coenhird/UV-Temperature-field-data-logger/materials for 5 data loggers 190321.docx

List to make 5 more loggers:

= $698.23 before shipping

MCU: 13.20 x 5 = 66

Low power breakout: 11.17 x 5 = 55.85

Temp sensor: 9.645 x 20 =192.9

MOSFET switch: 5.16 x 5 = 25.8

Logger shield: 13.15 x 5 = 65.75

Battery holder: 14.44 x 2 (10 holders) = 28.88

Toggle switch: 3.24 x 5 = 16.2

AA batteries: 14.99 x 8 = 119.92

SD card: 7.30 x 5 = 36.5

Headers: 1.95 x 15 = 29.25

Solder: 26.44

Hookup wire: 34.74

MCU x 5

https://core-electronics.com.au/uno-r3.html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

Low power breakout x 5

https://core-electronics.com.au/adafruit-tpl5110-low-power-timer-breakout.html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

Hookup wire x 1

https://core-electronics.com.au/hook-up-wire-assortment-solid-core-22-awg.html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

Temp sensor x 20

https://core-electronics.com.au/mcp9808-high-accuracy-i2c-temperature-sensor-breakout-board.html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

mini MOSFET switch x 5

https://core-electronics.com.au/mini-mosfet-slide-switch-with-reverse-voltage-protection-sv.html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

Logger x 5

https://www.auselectronicsdirect.com.au/data-logging-shield-with-sd-card-slot-for-arduino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

Battery holder x 2

https://au.rs-online.com/web/p/battery-holders/1756090/

Solder x 1

https://au.rs-online.com/web/p/solder/8007661/

Toggle switch x 5

https://au.rs-online.com/web/p/toggle-switches/7347062/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

Rechargeable AA batteries x 8

https://www.ikea.com/au/en/p/ladda-rechargeable-battery-70303876/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

SD card x 5

https://www.cheapchips.com.au/memory/verbatim-16gb-microsdhc-card-with-adapter-44082

Headers x 15

https://www.adafruit.com/product/85
