coenhird/UV-Temperature-field-data-logger/Power-cut_V3.pdf

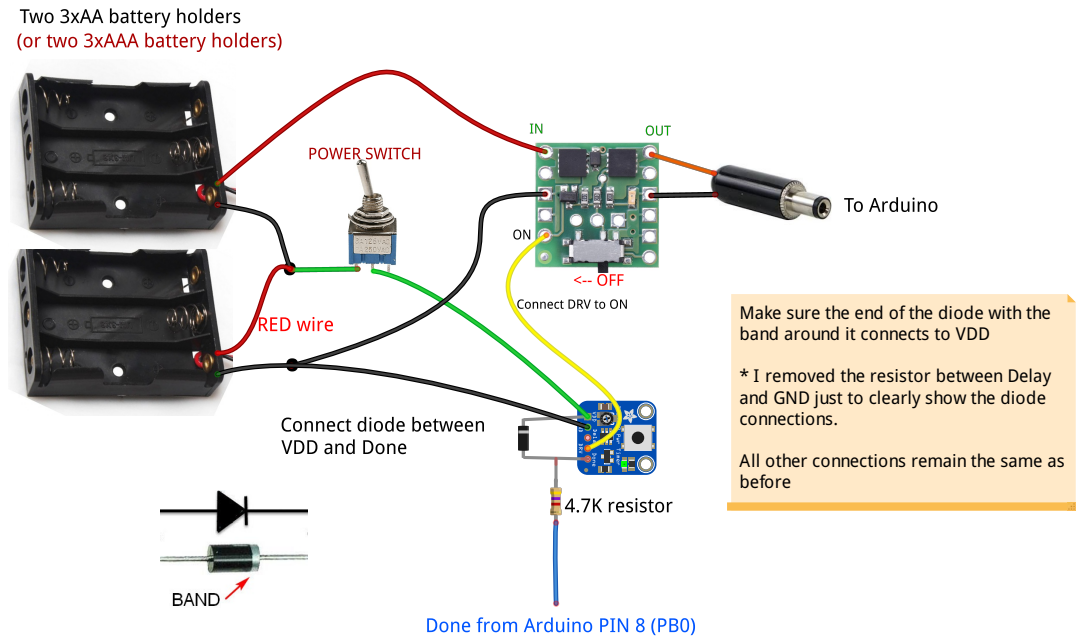
[picture p1: page 1]

Make sure the end of the diode with the
band around it connects to VDD

* I removed the resistor between Delay
and GND just to clearly show the diode
connections.

All other connections remain the same as
before
