coenhird/UV-Temperature-field-data-logger/Wiring diagram v1.png

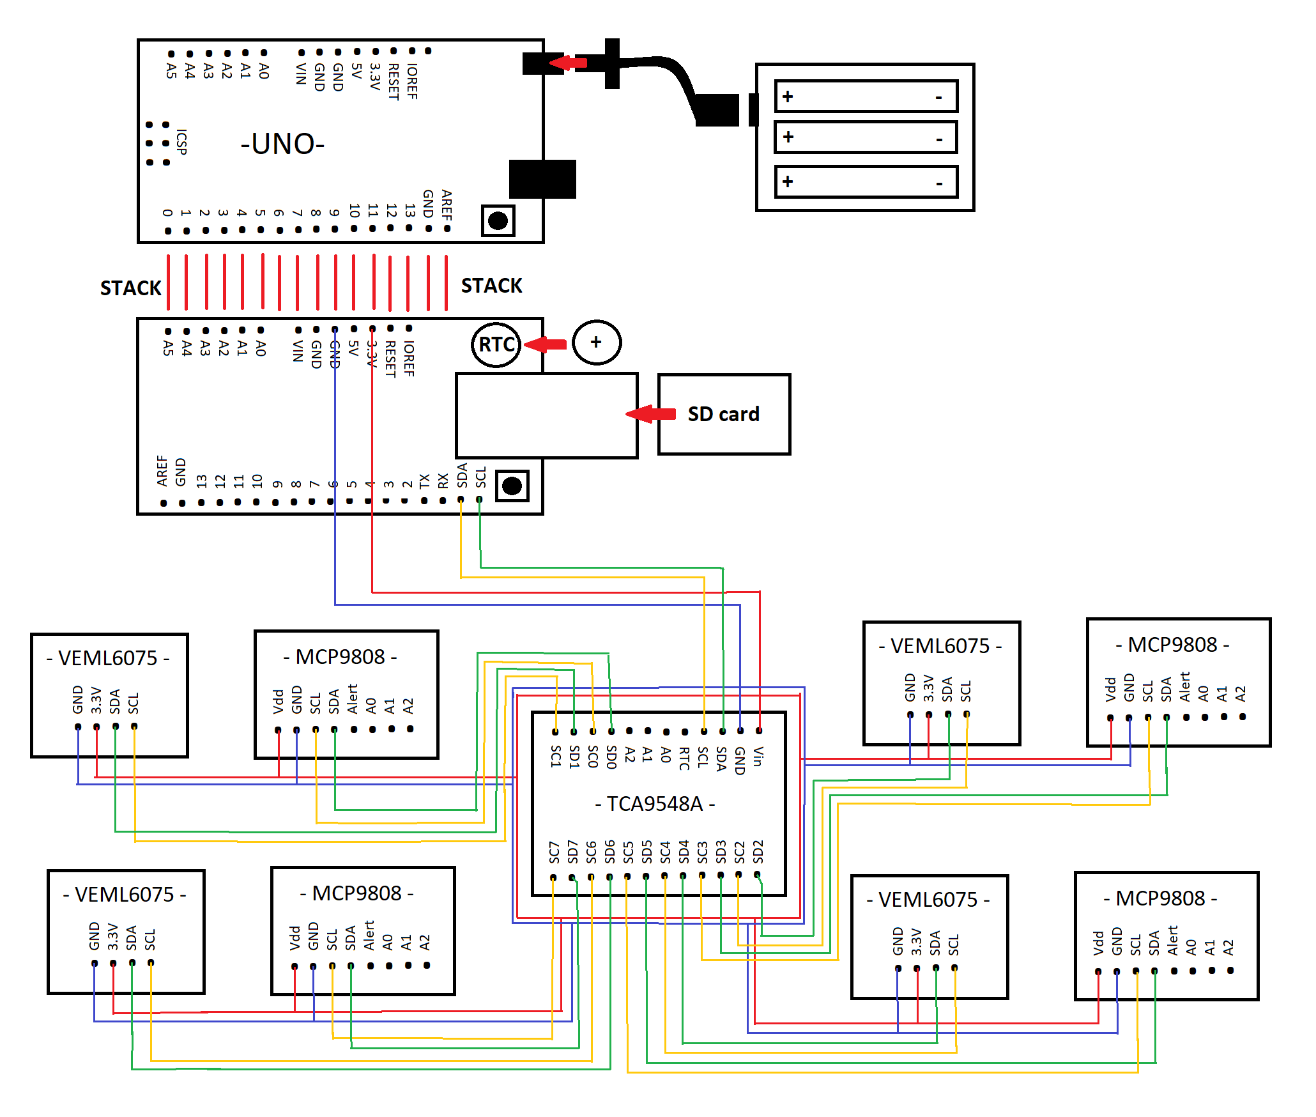
Wiring diagram v1.png
