coenhird/UV-Temperature-field-data-logger/(commit log)

2021-05-21 Add files via upload
    Program for logging UV and temperature data from three sensors.
2021-05-21 Add files via upload
    Calculating UVI with raw channel data
    [UVI_maths_corrections.xlsx]
2021-05-21 Add files via upload
    Wiring diagram of MCU, Logger shield, MUX, and sensors
2021-05-21 Add files via upload
    Wiring diagram of the low power system.
